FriedrichEckert/ASC_Prototype_v3/3D Bilder/ASC_Prototyp_Bot_v3.jpg

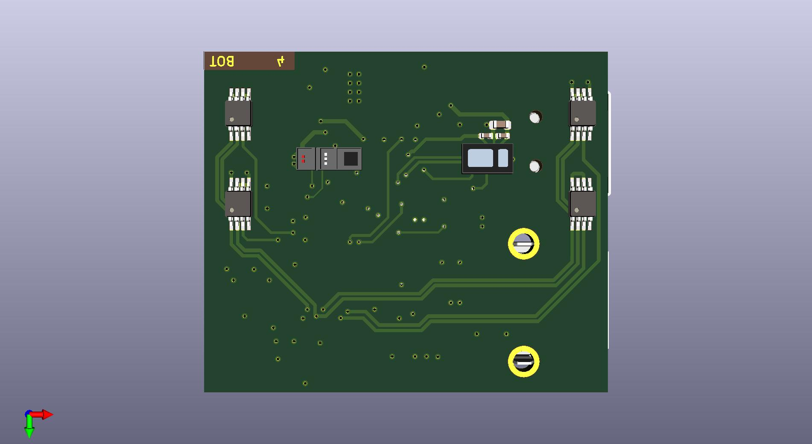
3D Bilder/ASC_Prototyp_Bot_v3.jpg
