FriedrichEckert/ASC_Prototype_v3/Layout Files/ASC_Prototyp BOM.ods

Referenz | Menge | Wert | Gehäuse | Bestellen | Einzelpreis | Postenpreis | Anmerkung | Link
C1 C2 C5 C6 C7 C13 C15 C30 | 8 | 100nF | 0402 | 10 | 0,0083 € | 0,0830 € |  | https://de.farnell.com/samsung-electro-mechanics/cl05a104ko5nnnc/kondensator-0-1uf-16v-mlcc-0402/dp/3013324
C10 C16 C18 C22 C24 C21 | 6 | 100nF | 0603 | 10 | 0,0144 € | 0,1440 € |  | https://de.farnell.com/kemet/c0603c104m4ractu/kondensator-0-1-f-16v-20-x7r-0603/dp/2581045
C11 | 1 | 4,7µF 16V | 0805 | 5 | 0,1720 € | 0,8600 € |  | https://de.farnell.com/taiyo-yuden/emk212b7475kg-t/kondensator-4-7-f-16v-10-x7r-0805/dp/2112841
C26 C12 C14 C20 | 4 | 1µF | 0603 | 10 | 0,0257 € | 0,2570 € |  | https://de.farnell.com/samsung-electro-mechanics/cl10b105mo8nnwc/kondensator-1uf-16v-mlcc-0603/dp/3013421
C28 C27 | 2 | 300nF | 0603 | 10 | 0,0621 € | 0,6210 € |  | https://de.farnell.com/walsin/0603b334k160ct/kondensat-0-33-f-16v-10-x7r-0603/dp/2524838
C29 | 1 | 10µF, 16V | 1210 | 1 | 0,5600 € | 0,5600 € |  | https://de.farnell.com/kemet/c1210c106m3ractu/kondensator-10-f-25v-20-x7r-1210/dp/2773356
C3 C4 | 2 | 14pF | 0402 | 10 | 0,1210 € | 1,2100 € |  | https://de.farnell.com/murata/gjm1555c1h140gb01d/cap-14pf-50v-mlcc-0402/dp/3243192
C8 | 1 | 2,2µF | 0603 | 10 | 0,0806 € | 0,8060 € |  | https://de.farnell.com/samsung-electro-mechanics/cl10b225kp8nnnc/kondensator-2-2uf-10v-mlcc-0603/dp/3013428
C9 C17 C19 C23 C25 | 5 | 4,7µF | 0603 | 10 | 0,0310 € | 0,3100 € |  | https://de.farnell.com/samsung-electro-mechanics/cl10a475kp8nnnc/kondensator-4-7uf-10v-mlcc-0603/dp/3013398
D1 D2 | 2 | ESDA6V1BC6 | SOT23-6 | 5 | 0,2600 € | 1,3000 € |  | https://de.farnell.com/stmicroelectronics/esda6v1bc6/esd-schutzdiode-5v-sot-23/dp/2353644?st=esda6v1bc6
FB1 FB2 FB3 | 3 | Ferrite_Bead | 0603 | 10 | 0,0299 € | 0,2990 € |  | https://de.farnell.com/murata/blm18pg121sn1d/ferrite-perle-0603-bauform-120ohm/dp/1515738
J1 | 1 | SWD_ARM10 | SWD_ARM10 | 1 | 2,7000 € | 2,7000 € |  | https://www.mouser.de/ProductDetail/Samtec/FTSH-105-01-L-DV-K-TR
J3 | 1 | USB_A | Custom | 1 | 0,7770 € | 0,7770 € |  | https://de.farnell.com/amphenol-icc-fci/87583-3010rpalf/usb-buchse-typ-a-4pos-smd/dp/2886155?st=usb
J4 | 1 | USB_B | Custom | 1 | 1,1700 € | 1,1700 € |  | https://de.farnell.com/harwin/m701-370442/usb-buchse-2-0-usb-typ-b-smd/dp/3225897
LED1 | 1 | SFH7072 | SFH7072 | 1 | 2,7900 € | 2,7900 € | Ab 23.06.2021 | https://www.mouser.de/ProductDetail/OSRAM-Opto-Semiconductors/SFH-7072
Q1 Q2 | 2 | PMOS | SOT23 | 5 | 0,0996 € | 0,4980 € |  | https://de.farnell.com/torex/xp222p0801tr-g/mosfet-p-kanal-0-8a-20v-sot-23/dp/3577859
R1 R8 R9 R4 | 4 | 10k | 0402 | 10 | 0,0041 € | 0,0410 € |  | https://de.farnell.com/multicomp/mcwr04x1002ftl/dickschichtwiderstand-10k-1-0/dp/2447096
R2 | 1 | 950R | 0402 | 10 | 0,0180 € | 0,1800 € |  | https://de.farnell.com/panasonic/erj2rkf9310x/dickschichtwiderstand-931r-1-0/dp/2302635
R3 R7 | 2 | 5k | 0603 | 0 | 0,0000 € | 0,0000 € |  | auf Lager
R5 | 1 | 430k | 0402 | 10 | 0,0050 € | 0,0500 € |  | https://de.farnell.com/multicomp/mcmr04x434-jtl/keramikwiderstand-430k-5-0-0625w/dp/2073041
R6 | 1 | 620k | 0402 | 10 | 0,0062 € | 0,0620 € |  | https://de.farnell.com/multicomp/mcmr04x6203ftl/keramikwiderstand-620k-1-0-0625w/dp/2073175
RV1 | 1 | Varistor | 0603 | 10 | 0,1270 € | 1,2700 € |  | https://de.farnell.com/epcos/b72500d0050h160/varistor-high-speed-150v-0603/dp/2476065
U1 | 1 | STM32F732RETx | LQFP64 | 1 | 9,3600 € | 9,3600 € |  | https://de.farnell.com/stmicroelectronics/stm32f732ret6/mcu-arm-cortex-m7-216mhz-lqfp/dp/2758797
U10 | 1 | AP1117-33 | SOT223 | 5 | 0,4960 € | 2,4800 € |  | https://de.farnell.com/diodes-inc/ap1117e33g-13/ldo-regler-3-3v-sot223/dp/1825291?st=ap1117
U11 | 1 | MIC5504-1.8YM5 | SOT23-5 | 1 | 0,1010 € | 0,1010 € |  | https://de.farnell.com/microchip/mic5504-1-8ym5-tr/ldo-festsp-regler-1-8v-0-3a-sot/dp/2809977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
U2 | 1 | STMPS2151STR | SOT23-5 | 1 | 0,6540 € | 0,6540 € |  | https://de.farnell.com/stmicroelectronics/stmps2151str/power-switch-1ch-500ma-sot23-5/dp/1842616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
U3 | 1 | MAX86141 | WLCSP20 | 1 | 6,1400 € | 6,1400 € |  | https://de.farnell.com/maxim-integrated-products/max86141enp-t/oximeter-herzfrequenzmesser-40/dp/2949171
U4 | 1 | NUF2042XV6T1G | SOT666 | 1 | 0,3300 € | 0,3300 € |  | https://www.mouser.de/ProductDetail/ON-Semiconductor/NUF2042XV6T1G?qs=ZXBb0xZ9WeAV3XcAwewBSw%3D%3D
U5 U6 U9 U8 | 4 | STDS75 | MSOP8 | 4 | 0,8820 € | 3,5280 € |  | https://de.farnell.com/stmicroelectronics/stds75ds2f/temperatursensor-0-5-c-msop-8/dp/2807098?st=thermo
U7 | 1 | FT234XD-R | DFN12 | 1 | 1,7800 € | 1,7800 € |  | https://de.farnell.com/ftdi/ft234xd-r/interface-usb-to-uart-dfn-12/dp/2419911
Y1 | 1 | 12MHz | SMD 3.2x2.5mm | 5 | 0,2060 € | 1,0300 € |  | https://de.farnell.com/multicomp/mcsjk-7u-12-00-10-10-80-b-10/quarz-12mhz-10pf-3-2mm-x-2-5mm/dp/2853914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
10 Pol ARM SWD Stecker |  |  |  | 1 | 1,9600 € | 1,9600 € |  | https://www.mouser.de/ProductDetail/Harwin/M50-3300542/?qs=gf2s0yP%252B7bc8KPddgFziWg%3D%3D
STLink V3 Mini |  |  |  | 1 | 8,6100 € | 8,6100 € |  | https://www.mouser.de/ProductDetail/STMicroelectronics/STLINK-V3MINI
Nettosumme |  |  |  |  |  | 51,9610 €
Mwst |  |  |  |  |  | 9,8726 €
Bruttosumme |  |  |  |  |  | 61,8336 €
