FriedrichEckert/ASC_Prototype_v3/Layout Files/Schematic.pdf

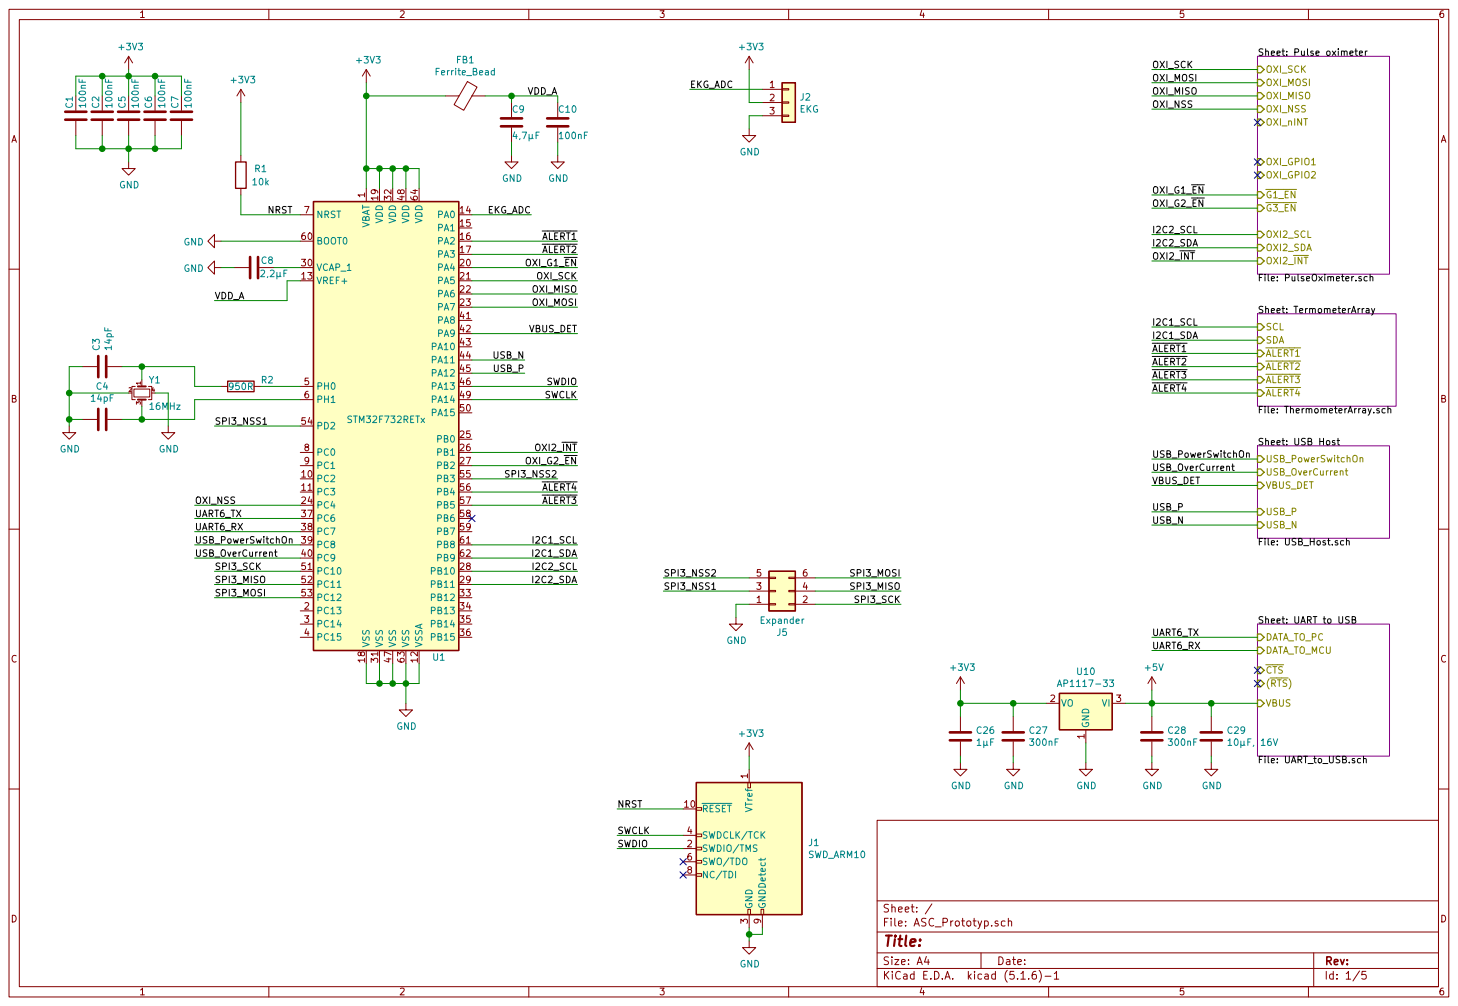
[picture p3: page 1]

Sheet: Pulse oximeter File: PulseOximeter.sch OXI_nINT OXI_SCK OXI_MOSI OXI_MISO
OXI_GPIO1 OXI_GPIO2 OXI_NSS G1_EN OXI2_SCL OXI2_SDA OXI2_INT G3_EN

1 VCAP_1 30 VDD 19 VDD 32 VDD 48 VDD 64 VREF+ 13 VSS 18 VSS 31 VSS 47 VSS 63 VSSA 12U1 STM32F732RETx GND C5100nF C6100nF C7100nF

Sheet: TermometerArray
File: ThermometerArray.sch ALERT1 ALERT2 SCL SDA

ALERT3 ALERT4 Sheet: USB Host File: USB_Host.sch USB_PowerSwitchOn USB_OverCurrent VBUS_DET USB_P USB_N

Sheet: UART to USB
File: UART_to_USB.sch DATA_TO_PC
DATA_TO_MCU
(RTS) CTS

1 VO 2 VI 3 U10 AP1117-33 GND GND GND C28

3 SWDCLK/TCK 4 SWO/TDO 6 NC/TDI 8 GNDDetect 9

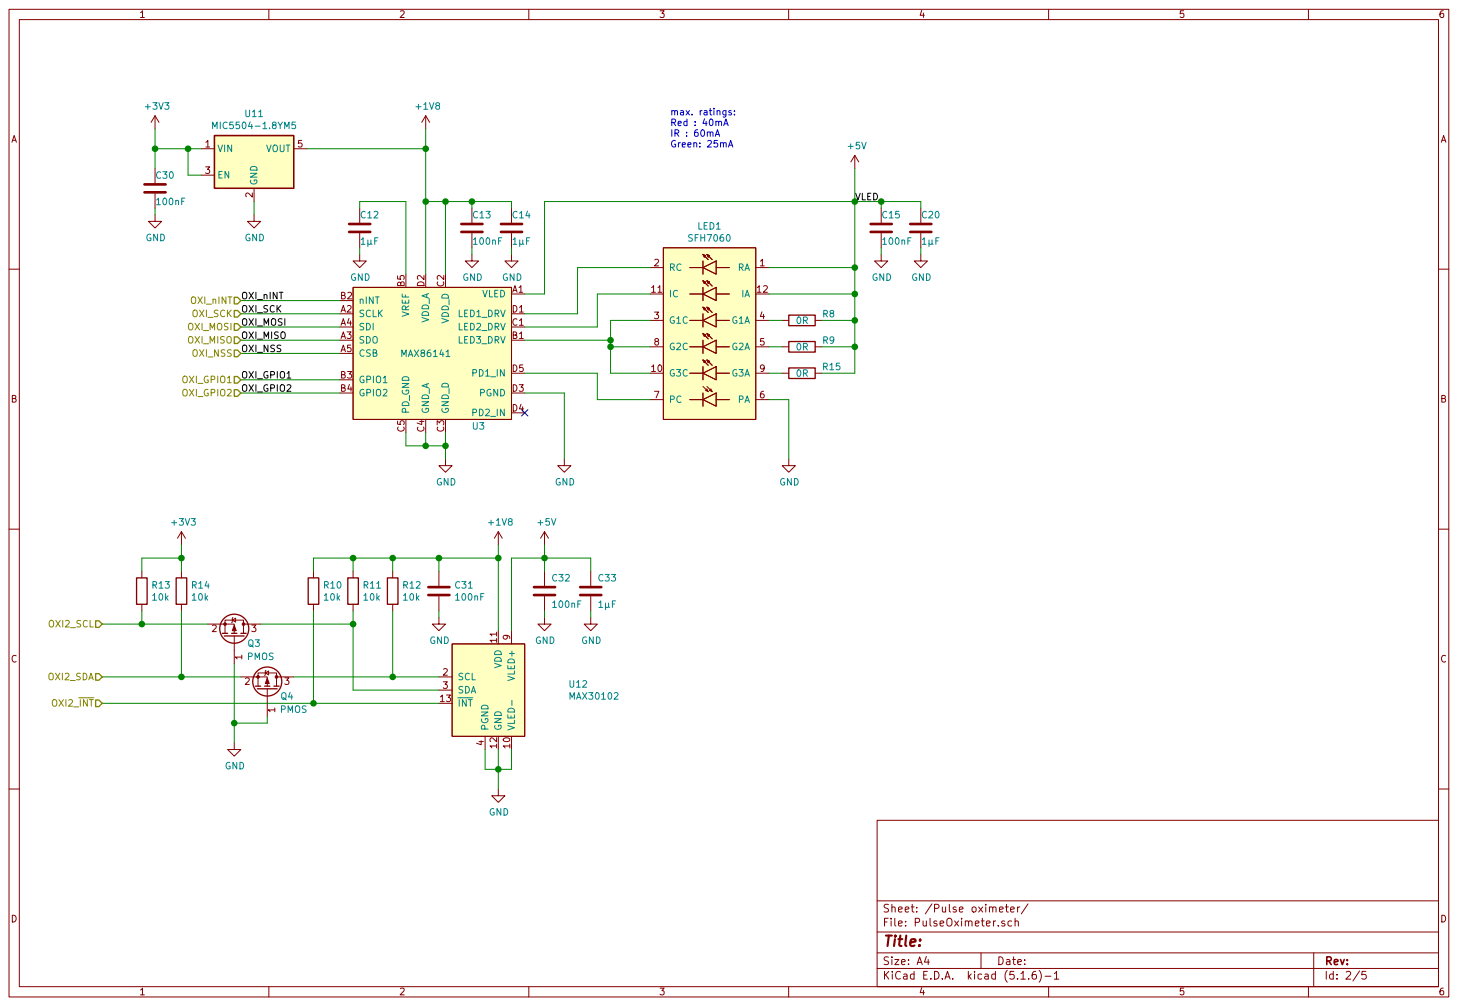
[picture p4: page 2]

Id: 2/5 Title: File: PulseOximeter.sch Sheet: /Pulse oximeter/

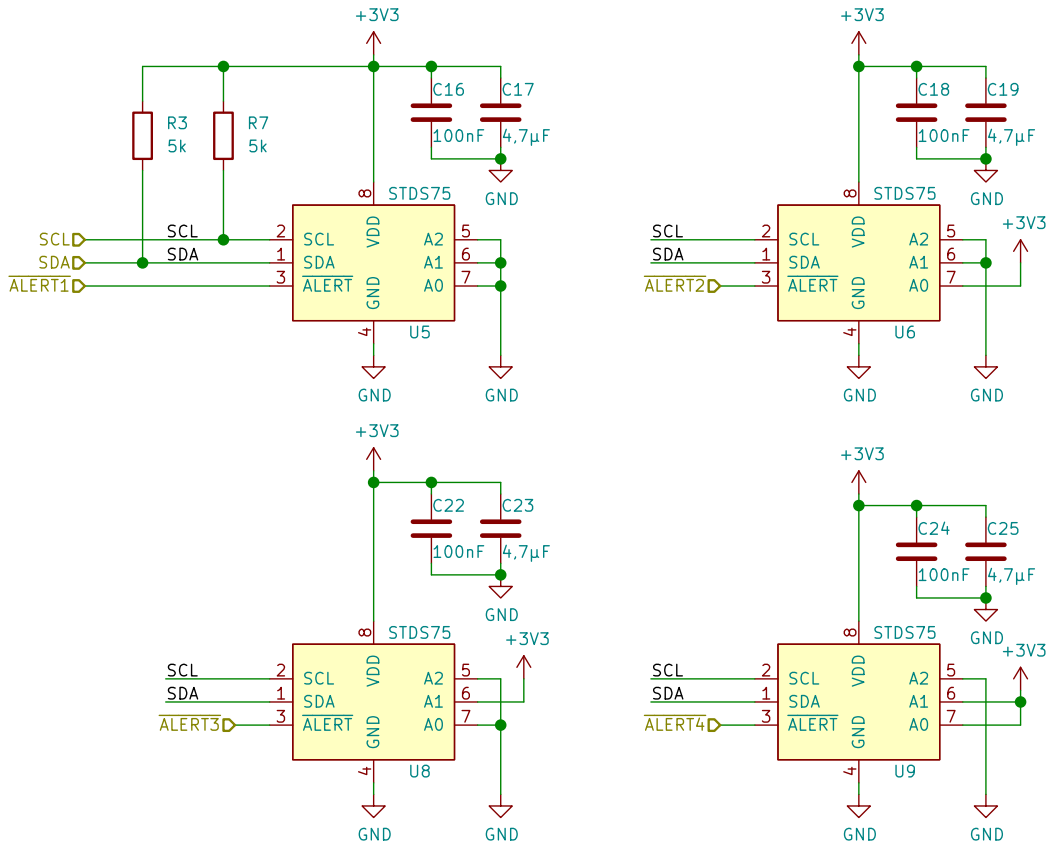
[picture p5: page 3]

8 U8 STDS75 +3V3 +3V3 SDA 1 SCL 2 ALERT 3 GND

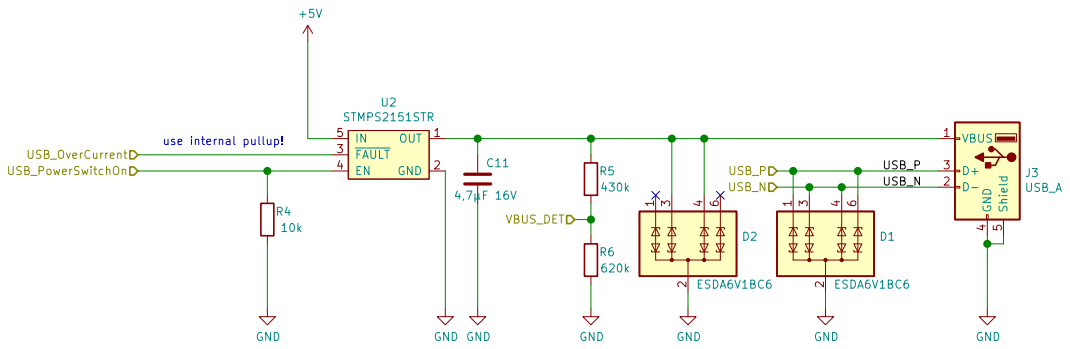
[picture p6: page 4]

6 D1 ESDA6V1BC6 GND GND GND OUT 1 GND 2 FAULT 3 EN 4

File: USB_Host.sch Sheet: /USB Host/
Id: 4/5 Title:

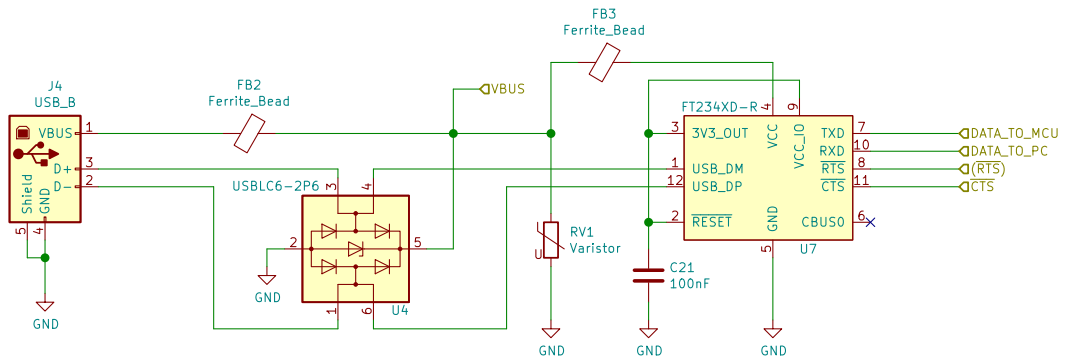
[picture p7: page 5]

File: UART_to_USB.sch Sheet: /UART to USB/
Id: 5/5 Title:
