FriedrichEckert/ASC_Prototype_v3/Layout Files/PCB Layout all Layer.pdf

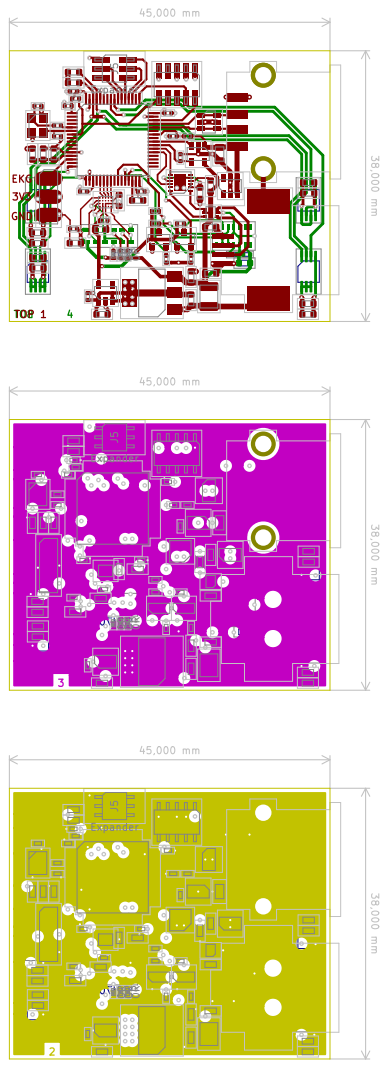
[picture p8: page 1]
