FriedrichEckert/ASC_Prototype_v3/Layout Files/PCB Layout GND.pdf

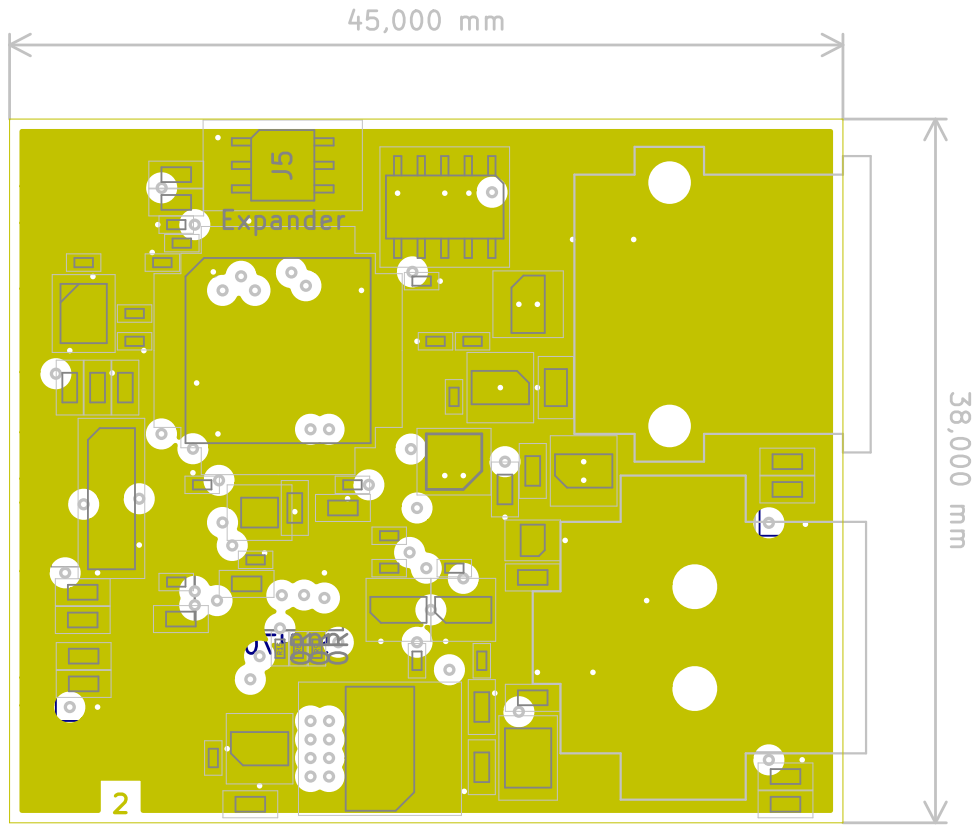
[picture p9: page 1]
