FriedrichEckert/ASC_Prototype_v3/Layout Files/PCB Layout VDD.pdf

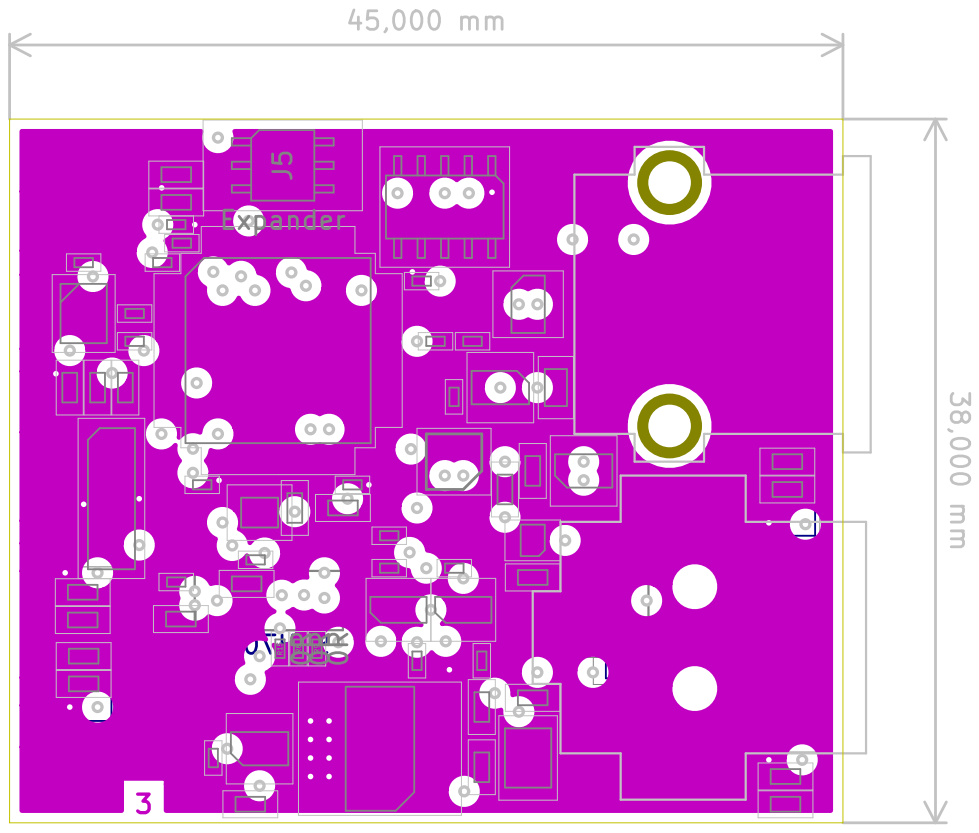
[picture p10: page 1]
