FriedrichEckert/ASC_Prototype_v3/ASC_Prototyp.kicad_pcb

## KiCad design ASC_Prototyp.kicad_pcb (2021-04-29)

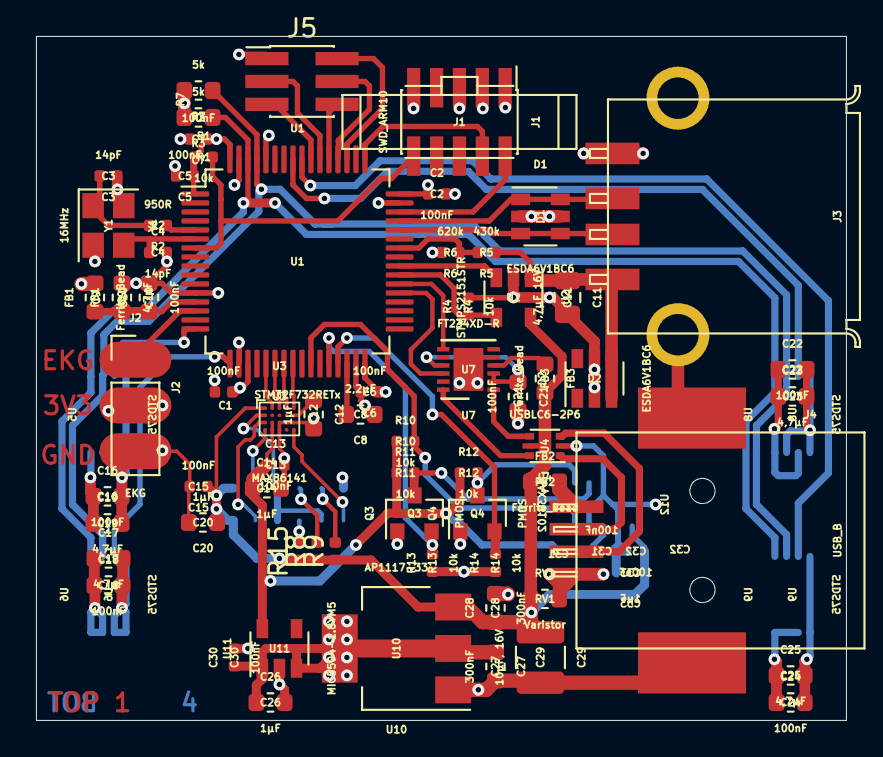
[picture p11: board ASC_Prototyp.kicad_pcb from above]

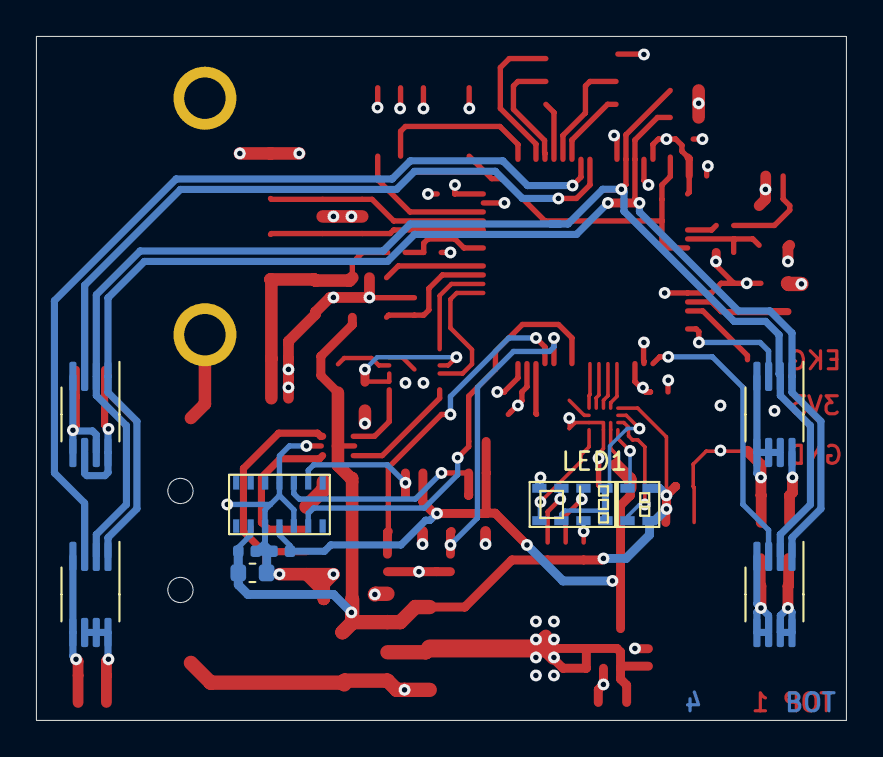
[picture p12: board ASC_Prototyp.kicad_pcb from below]

Board: 4 copper layers, 45.0 x 38.0 mm, 75 parts (9 on the bottom side), 56 nets.

Parts:
C1, C2, C5, C6, C7, C13, C15, C30, C31, C32: 100nF; C_0402_1005Metric
C3, C4: 14pF; C_0402_1005Metric
C8: 2,2µF; C_0603_1608Metric
C9, C17, C19, C23, C25: 4,7µF; C_0603_1608Metric
C10, C16, C18, C21, C22, C24: 100nF; C_0603_1608Metric
C11: 4,7µF 16V; C_0805_2012Metric
C12, C14, C20, C26, C33: 1µF; C_0603_1608Metric
C27, C28: 300nF; C_0603_1608Metric
C29: 10µF, 16V; C_1210_3225Metric
D1, D2: ESDA6V1BC6; SOT-23-6
FB1, FB2, FB3: Ferrite_Bead; L_0603_1608Metric
J1: SWD_ARM10
J2: EKG; PinHeader_1x03_P2.54mm_Vertical
J3: USB_A; USB_A_Buchse_87583-3010RPALF
J4: USB_B; USB_B_SMD
J5: Expander; PinHeader_2x03_P1.27mm_Vertical_SMD
LED1: SFH7060
Q3, Q4: PMOS; SOT-23
R1, R4, R10, R11, R12, R13, R14: 10k; R_0402_1005Metric
R2: 950R; R_0402_1005Metric
R3, R7: 5k; R_0603_1608Metric
R5: 430k; R_0402_1005Metric
R6: 620k; R_0402_1005Metric
R8, R9, R15: 0R; R_0402_1005Metric
RV1: Varistor; R_0603_1608Metric
U1: STM32F732RETx; LQFP-64_10x10mm_P0.5mm
U2: STMPS2151STR; SOT-23-5
U3: MAX86141; WLCSP-20_1.994x1.609mm_Layout5x4_P0.4mm_Modell
U4: USBLC6-2P6; SOT-666
U5, U6, U8, U9: STDS75; MSOP-8_3x3mm_P0.65mm
U7: FT234XD-R; DFN-12-1EP_3x3mm_P0.45mm_EP1.66x2.38mm
U10: AP1117-33; SOT-223-3_TabPin2
U11: MIC5504-1.8YM5; SOT-23-5
U12: MAX30102; MAX30102_LGA14
Y1: 16MHz; Crystal_SMD_3225-4Pin_3.2x2.5mm

Connections:
+1V8: C13.1, C14.1, C31.1, R10.1, R11.1, R12.1, U3.C2, U3.D2, U11.5, U12.11
+3V3: C1.1, C2.1, C5.1, C6.1, C7.1, C16.1, C17.1, C18.1, C19.1, C22.1, C23.1, C24.1, C25.1, C26.1, C27.1, C30.1, FB1.2, J1.1, J2.2, R1.1, R3.2, R7.2, R13.1, R14.1, U1.1, U1.19, U1.32, U1.48, U1.64, U5.8, U6.7, U6.8, U8.6, U8.8, U9.6, U9.7, U9.8, U10.2, U11.1, U11.3
+5V: C15.1, C20.1, C28.1, C29.1, C32.1, C33.1, FB2.1, FB3.2, LED1.1, LED1.12, R8.1, R9.1, R15.1, RV1.1, U2.5, U3.A1, U4.5, U10.3, U12.9
/EKG_ADC: J2.1, U1.14
/I2C1_SCL: R7.1, U1.61, U5.2, U6.2, U8.2, U9.2
/I2C1_SDA: R3.1, U1.62, U5.1, U6.1, U8.1, U9.1
/I2C2_SCL: Q3.2, R13.2, U1.28
/I2C2_SDA: Q4.2, R14.2, U1.29
/NRST: J1.10, R1.2, U1.7
/OXI2_~INT: R10.2, U1.26, U12.13
/OXI_MISO: U1.22, U3.A3
/OXI_MOSI: U1.23, U3.A4
/OXI_NSS: U1.24, U3.A5
/OXI_SCK: U1.21, U3.A2
/SPI3_MISO: J5.4, U1.52
/SPI3_MOSI: J5.6, U1.53
/SPI3_NSS1: J5.3, U1.54
/SPI3_NSS2: J5.5, U1.55
/SPI3_SCK: J5.2, U1.51
/SWCLK: J1.4, U1.49
/SWDIO: J1.2, U1.46
/UART6_RX: U1.38, U7.7
/UART6_TX: U1.37, U7.10
/USB_N: D1.3, D1.4, J3.2, U1.44
/USB_OverCurrent: U1.40, U2.3
/USB_P: D1.1, D1.6, J3.3, U1.45
/USB_PowerSwitchOn: R4.1, U1.39, U2.4
/VBUS_DET: R5.2, R6.1, U1.42
/VDD_A: C9.1, C10.1, FB1.1, U1.13
/~ALERT1: U1.16, U5.3
/~ALERT2: U1.17, U6.3
/~ALERT3: U1.57, U8.3
/~ALERT4: U1.56, U9.3
GND: C1.2, C2.2, C3.1, C4.2, C5.2, C6.2, C7.2, C8.1, C9.2, C10.2, C11.2, C12.2, C13.2, C14.2, C15.2, C16.2, C17.2, C18.2, C19.2, C20.2, C21.2, C22.2, C23.2, C24.2, C25.2, C26.2, C27.2, C28.2, C29.2, C30.2, C31.2, C32.2, C33.2, D1.2, D1.5, D2.2, D2.5, J1.3, J1.5, J1.9, J2.3, J3.4, J3.5, J4.4, J4.5, J5.1, LED1.6, Q3.1, Q4.1, R4.2, R6.2, RV1.2, U1.12, U1.18, U1.31, U1.47, U1.60, U1.63, U2.2, U3.C3, U3.C4, U3.C5, U3.D3, U4.2, U5.4, U5.5, U5.6, U5.7, U6.4, U6.5, U6.6, U7.5, U7.13, U8.4, U8.5, U8.7, U9.4, U9.5, U10.1, U11.2, U12.4, U12.10, U12.12, Y1.2, Y1.4
unnamed: C3.2, R2.2, Y1.1
unnamed: C4.1, U1.6, Y1.3
unnamed: C8.2, U1.30
unnamed: C11.1, D2.3, D2.4, J3.1, R5.1, U2.1
unnamed: C12.1, U3.B5
unnamed: C21.1, U7.2, U7.3, U7.9
unnamed: FB2.2, J4.1
unnamed: FB3.1, U7.4
unnamed: J4.2, U4.1
unnamed: J4.3, U4.3
unnamed: LED1.2, U3.D1
unnamed: LED1.4, R8.2
unnamed: LED1.5, R9.2
unnamed: LED1.7, U3.D5
unnamed: LED1.9, R15.2
unnamed: LED1.3, LED1.8, LED1.10, U3.B1
unnamed: LED1.11, U3.C1
unnamed: Q3.3, R11.2, U12.3
unnamed: Q4.3, R12.2, U12.2
unnamed: R2.1, U1.5
unnamed: U4.4, U7.1
unnamed: U4.6, U7.12
